bemcgarvey/SBus-Decoder/Software/SBusDecoderClient/images/servo.png

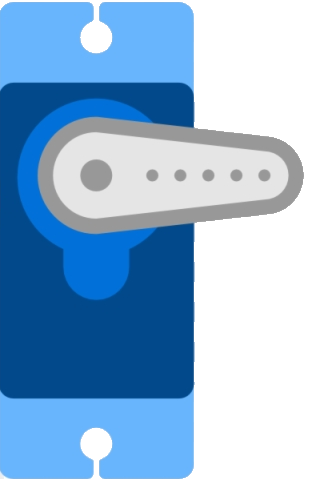
Software/SBusDecoderClient/images/servo.png
