bemcgarvey/SBus-Decoder/Schematic/SBus-Decoder/SBus-Decoder.kicad_sch

## KiCad design Schematic/SBus-Decoder/SBus-Decoder.kicad_sch (2022-01-19)

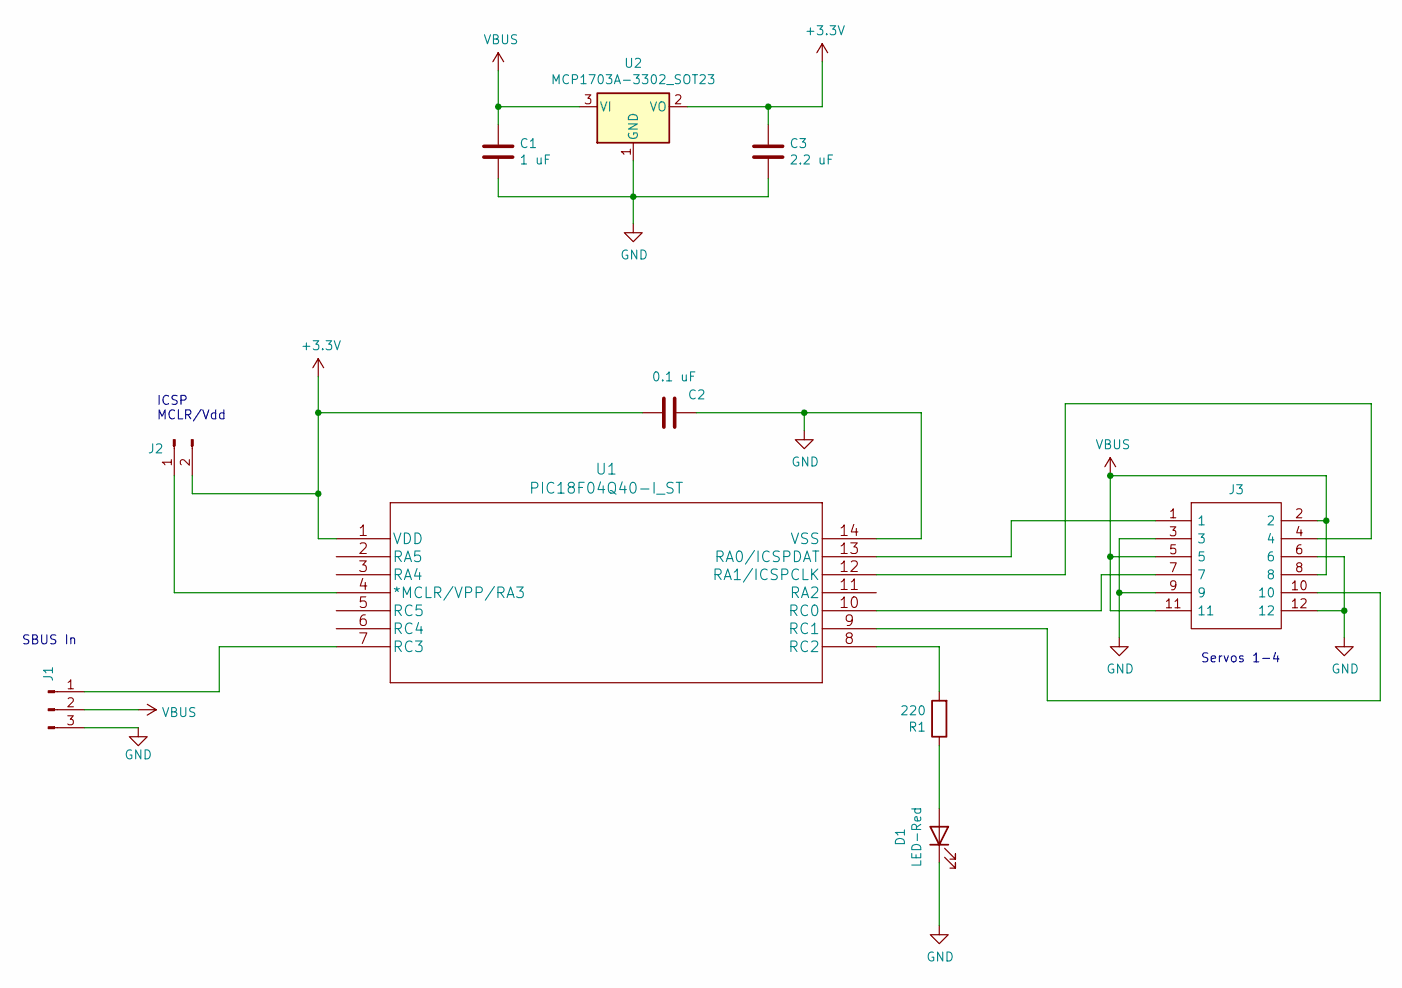
[picture p2: schematic SBus-Decoder.kicad_sch]

Parts:
C1: 1 uF; C_0603_1608Metric
C2: 0.1 uF; C_0603_1608Metric
C3: 2.2 uF; C_0603_1608Metric
D1: LED-Red; LED_0603_1608Metric
J1: Conn_01x03_Male; PinHeader_1x03_P2.54mm_Vertical
J2: Conn_01x02_Male; PinHeader_1x02_P2.54mm_Vertical
J3: TSW-104-08-G-T-RA; HDRRA12W64P254_3X4_1016X254X810P; Mouser Part Number 200-TSW10408GTRA
R1: 220; R_0603_1608Metric
U1: PIC18F04Q40-I_ST; PIC18F04Q40-I&slash_ST
U2: MCP1703A-3302_SOT23; SOT-23

Connections:
+3.3V: C2.2, C3.1, J2.2, U1.1 (VDD), U2.2 (VO)
GND: C1.2, C2.1, C3.2, D1.1 (K), J1.3, J3.3, J3.6, J3.9, J3.12, U1.14 (VSS), U2.1 (GND)
unnamed: D1.2 (A), R1.1
unnamed: J1.1, U1.7 (RC3)
unnamed: J2.1, U1.4 (*MCLR/VPP/RA3)
unnamed: J3.1, U1.13 (RA0/ICSPDAT)
unnamed: J3.4, U1.12 (RA1/ICSPCLK)
unnamed: J3.7, U1.10 (RC0)
unnamed: J3.10, U1.9 (RC1)
unnamed: R1.2, U1.8 (RC2)
VBUS: C1.1, J1.2, J3.2, J3.5, J3.8, J3.11, U2.3 (VI)

Notes on the sheet:
ICSP MCLR/Vdd
SBUS In
Servos 1-4
