bemcgarvey/SBus-Decoder/Software/SBusDecoderClient/mainwindow.cpp

#include "mainwindow.h"
#include "ui_mainwindow.h"
#include <QList>
#include <QSerialPortInfo>
#include <QMessageBox>
#include "aboutdialog.h"
#include <QTimer>
#include "stepdialog.h"
#include <cmath>
#include "version.h"

MainWindow::MainWindow(QWidget *parent)
    : QMainWindow(parent)
    , ui(new Ui::MainWindow), port(nullptr)
{
    ui->setupUi(this);
    setWindowTitle(QApplication::applicationName());
    portLabel = new QLabel("    ");
    connectedLabel = new QLabel("Not Connected");
    versionLabel = new QLabel("");
    ui->statusbar->addWidget(portLabel);
    ui->statusbar->addWidget(connectedLabel);
    ui->statusbar->addPermanentWidget(versionLabel);
    connect(ui->menuPort, &QMenu::aboutToShow, this, &MainWindow::updatePortMenu);
}

MainWindow::~MainWindow()
{
    delete ui;
}

void MainWindow::updateControls()
{
    ui->tabWidget->setCurrentIndex(settings.requestedMode - 1);
    //sBus tab
    ui->out1Channel->setCurrentIndex(settings.outputs[0].channel);
    ui->out1FrameRate->setCurrentIndex(settings.outputs[0].frameRate - 1);
    ui->out1Failsafe->setCurrentIndex(settings.outputs[0].failsafeMode - 1);
    ui->out2Channel->setCurrentIndex(settings.outputs[1].channel);
    ui->out2FrameRate->setCurrentIndex(settings.outputs[1].frameRate - 1);
    ui->out2Failsafe->setCurrentIndex(settings.outputs[1].failsafeMode - 1);
    ui->out3Channel->setCurrentIndex(settings.outputs[2].channel);
    ui->out3FrameRate->setCurrentIndex(settings.outputs[2].frameRate - 1);
    ui->out3Failsafe->setCurrentIndex(settings.outputs[2].failsafeMode - 1);
    ui->out4Channel->setCurrentIndex(settings.outputs[3].channel);
    ui->out4Failsafe->setCurrentIndex(settings.outputs[3].failsafeMode - 1);
    ui->out1Reverse->setChecked(settings.outputs[0].reverse);
    ui->out1subTrim->setValue(settings.outputs[0].subTrim);
    ui->out2Reverse->setChecked(settings.outputs[1].reverse);
    ui->out2subTrim->setValue(settings.outputs[1].subTrim);
    ui->out3Reverse->setChecked(settings.outputs[2].reverse);
    ui->out3subTrim->setValue(settings.outputs[2].subTrim);
    ui->out4Reverse->setChecked(settings.outputs[3].reverse);
    ui->out4subTrim->setValue(settings.outputs[3].subTrim);
    ui->passThrough4->setChecked(settings.options & SBUS_PASSTHROUGH4);
    ui->seqPassThrough->setChecked(settings.options & SBUS_PASSTHROUGH4);
    ui->revPassThrough->setChecked(settings.options & SBUS_PASSTHROUGH4);
    ui->passThrough3->setChecked(settings.options & SBUS_PASSTHROUGH3);
    //Sequencer tab
    if (settings.inputType == PWM) {
        ui->pwmInputRadioButton->setChecked(true);
        ui->sBusInputRadioButton->setChecked(false);
        ui->sbusOptionsFrame->setEnabled(false);
        ui->pwmInputRadioButton2->setChecked(true);
        ui->sBusInputRadioButton2->setChecked(false);
        ui->sbusOptionsFrame2->setEnabled(false);
    } else {
        ui->pwmInputRadioButton->setChecked(false);
        ui->sBusInputRadioButton->setChecked(true);
        ui->sbusOptionsFrame->setEnabled(true);
        ui->pwmInputRadioButton2->setChecked(false);
        ui->sBusInputRadioButton2->setChecked(true);
        ui->sbusOptionsFrame2->setEnabled(true);
    }
    ui->sBusInputChannel->setCurrentIndex(settings.sBusChannel);
    lowSteps.clear();
    for (int i = 0; i < settings.numLowSteps; ++i) {
        lowSteps.append(settings.lowSteps[i]);
    }
    highSteps.clear();
    for (int i = 0; i < settings.numHighSteps; ++i) {
        highSteps.append(settings.highSteps[i]);
    }
    updateLowSequenceList();
    updateHighSequenceList();
    //Reverser tab
    ui->revOut1->setChecked(settings.options & REV_OUT1);
    ui->revOut2->setChecked(settings.options & REV_OUT2);
    ui->revOut3->setChecked(settings.options & REV_OUT3);
    ui->revOut4->setChecked(settings.options & REV_OUT4);
    ui->revSubTrim->setValue(settings.revSubTrim);
    //Randomizer pad
    ui->randMaxServo->setValue(settings.random_max_servo);
    ui->randMinServo->setValue(settings.random_min_servo);
    ui->randMaxMove->setValue(settings.random_max_move);
    ui->randMinMove->setValue(settings.random_min_move);
    ui->randMaxTime->setValue(settings.random_max_time / 10.0);
    ui->randMinTime->setValue(settings.random_min_time / 10.0);
}


void MainWindow::updateSettings()
{
    //sBus tab
    settings.requestedMode = ui->tabWidget->currentIndex() + 1;
    settings.outputs[0].channel = ui->out1Channel->currentIndex();
    settings.outputs[0].frameRate = ui->out1FrameRate->currentIndex() + 1;
    settings.outputs[0].failsafeMode = ui->out1Failsafe->currentIndex() + 1;
    settings.outputs[1].channel = ui->out2Channel->currentIndex();
    settings.outputs[1].frameRate = ui->out2FrameRate->currentIndex() + 1;
    settings.outputs[1].failsafeMode = ui->out2Failsafe->currentIndex() + 1;
    settings.outputs[2].channel = ui->out3Channel->currentIndex();
    settings.outputs[2].frameRate = ui->out3FrameRate->currentIndex() + 1;
    settings.outputs[2].failsafeMode = ui->out3Failsafe->currentIndex() + 1;
    settings.outputs[3].channel = ui->out4Channel->currentIndex();
    settings.outputs[3].frameRate = ui->out4FrameRate->currentIndex() + 1;
    settings.outputs[3].failsafeMode = ui->out4Failsafe->currentIndex() + 1;
    settings.outputs[0].reverse = ui->out1Reverse->isChecked();
    settings.outputs[0].subTrim = ui->out1subTrim->value();
    settings.outputs[1].reverse = ui->out2Reverse->isChecked();
    settings.outputs[1].subTrim = ui->out2subTrim->value();
    settings.outputs[2].reverse = ui->out3Reverse->isChecked();
    settings.outputs[2].subTrim = ui->out3subTrim->value();
    settings.outputs[3].reverse = ui->out4Reverse->isChecked();
    settings.outputs[3].subTrim = ui->out4subTrim->value();
    if (ui->passThrough4->isChecked() || ui->seqPassThrough->isChecked()) {
        settings.options |= SBUS_PASSTHROUGH4;
    } else {
        settings.options &= ~SBUS_PASSTHROUGH4;
    }
    if (ui->passThrough3->isChecked()) {
        settings.options |= SBUS_PASSTHROUGH3;
    } else {
        settings.options &= ~SBUS_PASSTHROUGH3;
    }
    //Sequencer tab (some shared with reverser tab)
    if (ui->pwmInputRadioButton->isChecked()) {
        settings.inputType = PWM;
    } else {
        settings.inputType = SBUS;
    }
    settings.sBusChannel = ui->sBusInputChannel->currentIndex();
    settings.numLowSteps = lowSteps.size();
    for (int i = 0; i < lowSteps.size(); ++i) {
        settings.lowSteps[i] = lowSteps[i];
    }
    settings.numHighSteps = highSteps.size();
    for (int i = 0; i < highSteps.size(); ++i) {
        settings.highSteps[i] = highSteps[i];
    }
    //Reverser Tab
    settings.revSubTrim = ui->revSubTrim->value();
    if (ui->revOut1->isChecked()) {
        settings.options |= REV_OUT1;
    } else {
        settings.options &= ~REV_OUT1;
    }
    if (ui->revOut2->isChecked()) {
        settings.options |= REV_OUT2;
    } else {
        settings.options &= ~REV_OUT2;
    }
    if (ui->revOut3->isChecked()) {
        settings.options |= REV_OUT3;
    } else {
        settings.options &= ~REV_OUT3;
    }
    if (ui->revOut4->isChecked()) {
        settings.options |= REV_OUT4;
    } else {
        settings.options &= ~REV_OUT4;
    }
    //Randomizer Tab
    settings.random_max_servo = ui->randMaxServo->value();
    settings.random_min_servo = ui->randMinServo->value();
    if (settings.random_min_servo > settings.random_max_servo) {
        settings.random_min_servo = settings.random_max_servo;
    }
    settings.random_max_move = ui->randMaxMove->value();
    settings.random_min_move = ui->randMinMove->value();
    if (settings.random_min_move > settings.random_max_move) {
        settings.random_min_move = settings.random_max_move;
    }
    settings.random_max_time = static_cast<uint16_t>(std::round(ui->randMaxTime->value() * 10));
    settings.random_min_time = static_cast<uint16_t>(std::round(ui->randMinTime->value() * 10));
    if (settings.random_min_time > settings.random_max_time) {
        settings.random_min_time = settings.random_max_time;
    }
}

QString MainWindow::itemString(const SequenceStep &step) const
{
    QString str;
    if (step.type == SERVO) {
        str = QString("Output %1 to %2% in %3s")
                .arg(step.output)
                .arg(round((step.position - 1024) * (150.0 / 1024.0)))
                .arg(step.time / 10.0);
    } else {
        str = QString("Delay %1s").arg(step.time / 10.0);
    }
    return str;
}

void MainWindow::updatePortMenu()
{
    QList<QSerialPortInfo> portList = QSerialPortInfo::availablePorts();
    ui->menuPort->clear();
    if (portList.size() == 0) {
        ui->menuPort->addAction("No ports found");
        portLabel->setText("    ");
        connectedLabel->setText("Not Connected");
        return;
    }
    for (auto&& i : portList) {
        QAction *action = ui->menuPort->addAction(i.portName(), this, &MainWindow::comPortSelected);
        action->setCheckable(true);
        if (i.portName() == portLabel->text()) {
            action->setChecked(true);
        }
    }
}

void MainWindow::comPortSelected()
{
    QAction *action = dynamic_cast<QAction *>(sender());
    port.reset(new QSerialPort(action->text(), this));
    if (port->open(QIODevice::ReadWrite)) {
        port->setBaudRate(QSerialPort::Baud115200);
        port->setDataBits(QSerialPort::Data8);
        port->setParity(QSerialPort::NoParity);
        port->setStopBits(QSerialPort::OneStop);
        portLabel->setText(action->text());
        connectedLabel->setText("Connected");
        ui->readPushButton->setEnabled(true);
        action->setChecked(true);
        port->clear(QSerialPort::AllDirections);  //clear out extra bytes from device power on
        connect(port.get(), &QSerialPort::readyRead, this, &MainWindow::onReadyRead);
    } else {
        port.release();
        portLabel->setText("    ");
        connectedLabel->setText("Not Connected");
        ui->readPushButton->setEnabled(false);
        ui->writePushButton->setEnabled(false);
    }
}

void MainWindow::onReadyRead()
{
    int received;
    while (port->bytesAvailable() > 0) {
        switch (rxState) {
        case RX_IDLE:
            port->clear(QSerialPort::Input);
            break;
        case RX_VERSION:
            received = port->read(bufferPos, bytesNeeded);
            bytesNeeded -= received;
            bufferPos += received;
            if (bytesNeeded == 0) {
                versionLabel->setText(QString("Firmware Version %1.%2")
                        .arg(static_cast<int>(rxBuffer[0]))
                        .arg(static_cast<int>(rxBuffer[1])));
                if (rxBuffer[0] != MAJOR_VERSION || rxBuffer[1] != MINOR_VERSION) {
                    rxState = RX_IDLE;
                    QMessageBox::critical(this, QApplication::applicationName(),
                                          "Firmware out of date.  Please update firmware.");
                    ui->readPushButton->setEnabled(true);
                    //ui->writePushButton->setEnabled(true);
                } else {
                    char cmd = 's';
                    port->write(&cmd, 1);
                    rxState = RX_SETTINGS;
                    bytesNeeded = sizeof(Settings) + 1; //Extra byte for checksum
                    bufferPos = rxBuffer;
                }
            }
            break;
        case RX_SETTINGS:
            received = port->read(bufferPos, bytesNeeded);
            bytesNeeded -= received;
            bufferPos += received;
            if (bytesNeeded == 0) {
                uint8_t chk = calcChecksum(reinterpret_cast<uint8_t *>(rxBuffer));
                if (chk == static_cast<uint8_t>(rxBuffer[sizeof (Settings)])) {
                    memcpy(&settings, rxBuffer, sizeof(Settings));
                    rxState = RX_IDLE;
                    updateControls();
                } else {
                    QMessageBox::critical(this, QApplication::applicationName(), "Error reading device");
                }
                ui->readPushButton->setEnabled(true);
                ui->writePushButton->setEnabled(true);
            }
            break;
        case RX_ACK:
            received = port->read(bufferPos, bytesNeeded);
            bytesNeeded -= received;
            bufferPos += received;
            if (bytesNeeded == 0) {
                rxState = RX_IDLE;
                if (rxBuffer[0] == ACK) {
                    QMessageBox::information(this, QApplication::applicationName(), "Settings saved");
                } else {
                    QMessageBox::critical(this, QApplication::applicationName(), "An Error occurred while saving settings.");
                }
                ui->readPushButton->setEnabled(true);
                ui->writePushButton->setEnabled(true);
            }
            break;
        }
    }
}


void MainWindow::on_actionExit_triggered()
{
    close();
}


void MainWindow::on_readPushButton_clicked()
{
    char tx = 'v';
    port->write(&tx, 1);
    bytesNeeded = 2;
    bufferPos = rxBuffer;
    rxState = RX_VERSION;
    QTimer::singleShot(500, this, &MainWindow::rxTimeout);
    ui->readPushButton->setEnabled(false);
    ui->writePushButton->setEnabled(false);
}


void MainWindow::on_out3FrameRate_currentIndexChanged(int index)
{
    ui->out4FrameRate->setCurrentIndex(index);
}


void MainWindow::on_writePushButton_clicked()
{
    updateSettings();
    if (settings.requestedMode == SERVO_SEQUENCER) {
        bool valid = true;
        if (settings.options & SBUS_PASSTHROUGH4) {
            for (int i = 0; i < settings.numLowSteps; ++i) {
                if (settings.lowSteps[i].output == 4) {
                    valid = false;
                }
            }
            for (int i = 0; i < settings.numHighSteps; ++i) {
                if (settings.highSteps[i].output == 4) {
                    valid = false;
                }
            }
            if (!valid) {
                QMessageBox::warning(this, QApplication::applicationName(),
                    "sBus passthrough is enabled on output 4"
                    " and at least one event uses output 4.  "
                    "Please correct the conflict before proceeding.");
                return;
            }
        }
    }
    char cmd = 'u';
    port->write(&cmd, 1);
    port->write(reinterpret_cast<char *>(&settings.requestedMode), sizeof(Settings));
    uint8_t chksum = calcChecksum(reinterpret_cast<uint8_t *>(&settings));
    port->write(reinterpret_cast<char *>(&chksum), 1);
    rxState = RX_ACK;
    bytesNeeded = 1;
    bufferPos = rxBuffer;
    rxBuffer[0] = 0xff; //make sure there is not a left over ACK in the buffer
    QTimer::singleShot(3000, this, &MainWindow::rxTimeout);
    ui->readPushButton->setEnabled(false);
    ui->writePushButton->setEnabled(false);
}


void MainWindow::on_actionAbout_triggered()
{
    std::unique_ptr<AboutDialog> dlg(new AboutDialog(this));
    dlg->exec();
}


void MainWindow::rxTimeout()
{
    if (rxState == RX_VERSION || rxState == RX_SETTINGS || rxState == RX_ACK) {
        rxState = RX_IDLE;
        QMessageBox::critical(this, QApplication::applicationName(), "Communication timeout.  Operation failed");
        ui->readPushButton->setEnabled(true);
        ui->writePushButton->setEnabled(true);
    }
}


void MainWindow::on_passThrough3_stateChanged(int arg1)
{
    ui->out3Channel->setCurrentIndex(0);
    ui->output3Frame->setEnabled(!arg1);
}


void MainWindow::on_passThrough4_stateChanged(int arg1)
{
    ui->out4Channel->setCurrentIndex(0);
    ui->output4Frame->setEnabled(!arg1);
    if (arg1 != ui->seqPassThrough->isChecked()) {
        ui->seqPassThrough->setChecked(arg1);
    }
    if (arg1 != ui->revPassThrough->isChecked()) {
        ui->revPassThrough->setChecked(arg1);
    }
    ui->revOut4->setEnabled(!ui->passThrough4->isChecked());
    if (ui->passThrough4->isChecked()) {
        ui->revOut4->setChecked(false);
    }

}


void MainWindow::on_pwmInputRadioButton_clicked(bool checked)
{
    ui->sbusOptionsFrame->setEnabled(!checked);
    ui->sbusOptionsFrame2->setEnabled(!checked);
    ui->pwmInputRadioButton2->setChecked(checked);
    if (checked) {
        ui->sBusInputChannel->setCurrentIndex(0);
        ui->seqPassThrough->setChecked(false);
        ui->sBusInputChannel2->setCurrentIndex(0);
        ui->revPassThrough->setChecked(false);
    }
}


void MainWindow::on_sBusInputRadioButton_clicked(bool checked)
{
    ui->sbusOptionsFrame->setEnabled(checked);
    ui->sbusOptionsFrame2->setEnabled(checked);
    ui->sBusInputRadioButton2->setChecked(checked);
}



void MainWindow::on_seqPassThrough_stateChanged(int arg1)
{
    if (arg1 != ui->passThrough4->isChecked()) {
        ui->passThrough4->setChecked(arg1);
    }
    if (arg1 != ui->revPassThrough->isChecked()) {
        ui->revPassThrough->setChecked(arg1);
    }
}


void MainWindow::on_lowPlusButton_clicked()
{
    int currentRow = ui->lowSequenceList->currentRow();
    int select = -1;
    if (lowSteps.size() < MAX_SEQUENCE_STEPS) {
        SequenceStep step;
        step.output = 1;
        step.type = SERVO;
        step.position = 1024;
        step.time = 0;
        if (currentRow == lowSteps.size() - 1 || currentRow < 0) {
            lowSteps.append(step);
            select = lowSteps.size() - 1;
        } else {
            lowSteps.insert(currentRow + 1, step);
            select = currentRow + 1;
        }
        unique_ptr<StepDialog> dlg(new StepDialog(this, lowSteps[select], !ui->passThrough4->isChecked()));
        if (dlg->exec() == QDialog::Rejected) {
            lowSteps.removeAt(select);
            select = currentRow;
        }
        updateLowSequenceList(select);
    }
}


void MainWindow::on_lowSequenceList_itemDoubleClicked(QListWidgetItem *item)
{
    Q_UNUSED(item);
    int stepNum = ui->lowSequenceList->currentRow();
    unique_ptr<StepDialog> dlg(new StepDialog(this, lowSteps[stepNum], !ui->passThrough4->isChecked()));
    if (dlg->exec() == QDialog::Accepted) {
        updateLowSequenceList(stepNum);
    }
}

void MainWindow::updateLowSequenceList(int select)
{
    ui->lowSequenceList->clear();
    for (auto &&i : lowSteps) {
        ui->lowSequenceList->addItem(itemString(i));
    }
    ui->lowSequenceList->setCurrentRow(select);
}

void MainWindow::updateHighSequenceList(int select) {
    ui->highSequenceList->clear();
    for (auto &&i : highSteps) {
        ui->highSequenceList->addItem(itemString(i));
    }
    ui->highSequenceList->setCurrentRow(select);
}

void MainWindow::on_lowXButton_clicked()
{
    int stepNum = ui->lowSequenceList->currentRow();
    if (stepNum >= 0) {
        lowSteps.removeAt(stepNum);
        updateLowSequenceList(std::max(0, stepNum - 1));
    }
}


void MainWindow::on_highPlusButton_clicked()
{
    int currentRow = ui->highSequenceList->currentRow();
    int select = -1;
    if (highSteps.size() < MAX_SEQUENCE_STEPS) {
        SequenceStep step;
        step.output = 1;
        step.type = SERVO;
        step.position = 1024;
        step.time = 0;
        if (currentRow == highSteps.size() - 1 || currentRow < 0) {
            highSteps.append(step);
            select = highSteps.size() - 1;
        } else {
            highSteps.insert(currentRow + 1, step);
            select = currentRow + 1;
        }
        unique_ptr<StepDialog> dlg(new StepDialog(this, highSteps[select], !ui->passThrough4->isChecked()));
        if (dlg->exec() == QDialog::Rejected) {
            highSteps.removeAt(select);
            select = currentRow;
        }
        updateHighSequenceList(select);
    }
}


void MainWindow::on_highXButton_clicked()
{
    int stepNum = ui->highSequenceList->currentRow();
    if (stepNum >= 0) {
        highSteps.removeAt(stepNum);
        updateHighSequenceList(std::max(0, stepNum - 1));
    }
}


void MainWindow::on_highSequenceList_itemDoubleClicked(QListWidgetItem *item)
{
    Q_UNUSED(item);
    int stepNum = ui->highSequenceList->currentRow();
    unique_ptr<StepDialog> dlg(new StepDialog(this, highSteps[stepNum], !ui->passThrough4->isChecked()));
    if (dlg->exec() == QDialog::Accepted) {
        updateHighSequenceList(stepNum);
    }
}


void MainWindow::on_lowUpButton_clicked()
{
    int pos = ui->lowSequenceList->currentRow();
    if (pos > 0) {
        lowSteps.swapItemsAt(pos, pos - 1);
        updateLowSequenceList(pos - 1);
    }
}


void MainWindow::on_lowDownButton_clicked()
{
    int pos = ui->lowSequenceList->currentRow();
    if (pos >= 0 && pos < lowSteps.size() - 1) {
        lowSteps.swapItemsAt(pos, pos + 1);
        updateLowSequenceList(pos + 1);
    }
}


void MainWindow::on_rightButton_clicked()
{
    int lowPos = ui->lowSequenceList->currentRow();
    int highPos = ui->highSequenceList->currentRow();
    if (lowPos >= 0 && highSteps.size() < MAX_SEQUENCE_STEPS) {
        if (highPos < 0) {
            highSteps.append(lowSteps[lowPos]);
            highPos = highSteps.size() - 1;
        } else {
            highPos += 1;
            highSteps.insert(highPos, lowSteps[lowPos]);
        }
        updateHighSequenceList(highPos);
    }
}


void MainWindow::on_leftButton_clicked()
{
    int lowPos = ui->lowSequenceList->currentRow();
    int highPos = ui->highSequenceList->currentRow();
    if (highPos >= 0 && lowSteps.size() < MAX_SEQUENCE_STEPS) {
        if (lowPos < 0) {
            lowSteps.append(highSteps[highPos]);
            lowPos = lowSteps.size() - 1;
        } else {
            lowPos += 1;
            lowSteps.insert(lowPos, highSteps[highPos]);
        }
        updateLowSequenceList(lowPos);
    }
}


void MainWindow::on_highUpButton_clicked()
{
    int pos = ui->highSequenceList->currentRow();
    if (pos > 0) {
        highSteps.swapItemsAt(pos, pos - 1);
        updateHighSequenceList(pos - 1);
    }
}


void MainWindow::on_highDownButton_clicked()
{
    int pos = ui->highSequenceList->currentRow();
    if (pos >= 0 && pos < highSteps.size() - 1) {
        highSteps.swapItemsAt(pos, pos + 1);
        updateHighSequenceList(pos + 1);
    }
}


void MainWindow::on_tabWidget_currentChanged(int index)
{
    ui->testButton2->setChecked(false);
    if (index != 0) {
        ui->passThrough3->setChecked(false);
    }
}

void MainWindow::setServo(int16_t value)
{
    if (port) {
        char cmd;
        if (value >= 0) {
            cmd = 't';
            port->write(&cmd, 1);
            port->write(reinterpret_cast<char *>(&value), 2);
        } else {
            cmd = 'x';
            port->write(&cmd, 1);
        }
    }
}


void MainWindow::on_sBusInputRadioButton2_clicked(bool checked)
{
    ui->sBusInputRadioButton->setChecked(checked);
    on_sBusInputRadioButton_clicked(checked);
}


void MainWindow::on_pwmInputRadioButton2_clicked(bool checked)
{
    ui->pwmInputRadioButton->setChecked(checked);
    on_pwmInputRadioButton_clicked(checked);
}


void MainWindow::on_revPassThrough_stateChanged(int arg1)
{
    if (arg1 != ui->passThrough4->isChecked()) {
        ui->passThrough4->setChecked(arg1);
    }
    if (arg1 != ui->seqPassThrough->isChecked()) {
        ui->seqPassThrough->setChecked(arg1);
    }
}


void MainWindow::on_sBusInputChannel2_currentIndexChanged(int index)
{
    if (ui->sBusInputChannel->currentIndex() != index) {
        ui->sBusInputChannel->setCurrentIndex(index);
    }
}


void MainWindow::on_sBusInputChannel_currentIndexChanged(int index)
{
    if (ui->sBusInputChannel2->currentIndex() != index) {
        ui->sBusInputChannel2->setCurrentIndex(index);
    }
}


void MainWindow::on_testButton2_toggled(bool checked)
{
    if (checked) {
        if (QMessageBox::warning(this, QApplication::applicationName(),
                                 "Before proceeding:\n"
                                 "   1) Remove the bind plug from output 4\n"
                                 "   2) Plug a servo into output 4\n"
                                 "Failure to do so can result in damage to the output pin",
                                 QMessageBox::Ok | QMessageBox::Cancel)
                == QMessageBox::Cancel) {
            ui->testButton2->setChecked(false);
            return;
        }
        setServo(ui->revSubTrim->value() + 1024);
    } else {
        setServo(-1);
    }
}


void MainWindow::on_revSubTrim_valueChanged(int arg1)
{
    if (ui->testButton2->isChecked()) {
        setServo(arg1 + 1024);
    }
}
