bemcgarvey/SBus-Decoder/Software/SBusDecoderClient/main.cpp

#include "mainwindow.h"

#include <QApplication>
#include <QScreen>

int main(int argc, char *argv[])
{
    QApplication::setOrganizationName("QES");
    QApplication::setApplicationName("sBus Decoder");
    QApplication a(argc, argv);
    MainWindow w;
    QScreen *screen = QGuiApplication::primaryScreen();
    QRect  screenGeometry = screen->geometry();
    int width = screenGeometry.width();
    w.move(width / 2 - w.width() / 2, 10);
    w.show();
    return a.exec();
}
