bemcgarvey/SBus-Decoder/Firmware/SBus-Decoder.X/version.h

/* 
 * File:   version.h
 * Author: bemcg
 *
 * Created on August 9, 2021, 8:10 PM
 */

#ifndef VERSION_H
#define	VERSION_H

#define MAJOR_VERSION   1
#define MINOR_VERSION   2

#endif	/* VERSION_H */
