bemcgarvey/SBus-Decoder/Firmware/SBus-Decoder.X/serial.h

/////////////////////////////////////////////////////
// Project: SBus-Decoder                           //
// File: serial.h                                  //
// Target: PIC18F0xQ40                             // 
// Compiler: XC8                                   //
// Author: Brad McGarvey                           //
// License: GNU General Public License v3.0        //
// Description: serial functions (non-sBus)        //
/////////////////////////////////////////////////////

#ifndef SERIAL_H
#define	SERIAL_H

#include <stdbool.h>

enum {ACK = 0x06, NACK = 0x15};

bool detectSerial(void);
void initSerial(void);
void serialTasks(void);

#endif	/* SERIAL_H */
