bemcgarvey/SBus-Decoder/(commit log)

2021-07-16 Initial Schematic
    [SBus-Decoder.kicad_pcb, SBus-Decoder.sch]
2021-07-16 Added CLC connections
    Need CLC to invert SBus serial signal
    [SBus-Decoder.sch]
2021-07-18 Switched to 32MHz Fosc
2021-07-19 Changed connectors
    [SBus-Decoder.kicad_pcb, SBus-Decoder.sch]
2021-07-19 Initial pcb
    [SBus-Decoder.kicad_pcb]
2021-07-20 Schematic and pcb
    [SBus-Decoder.kicad_pcb, SBus-Decoder.sch]
2021-07-21 Single pcb layout complete
    [SBus-Decoder.kicad_pcb]
2021-07-21 Changed input connector footprint
    Using a 2.54 pin header will allow for more flexibility for other uses (like a servo sequencer.)
    [SBus-Decoder.kicad_pcb, SBus-Decoder.sch]
2021-07-21 Better ICSP setup
    [SBus-Decoder.kicad_pcb, SBus-Decoder.sch]
2021-07-22 Paneled and generated gerbers
    [SBus-Decoder-B_Cu.gbr, SBus-Decoder-B_Mask.gbr, SBus-Decoder-B_SilkS.gbr, SBus-Decoder-Edge_Cuts.gbr, SBus-Decoder-F_Cu.gbr, SBus-Decoder-F_Mask.gbr, SBus-Decoder-F_SilkS.gbr, SBus-Decoder-NPTH.drl]
2021-08-07 Switched serial to UART2
2021-08-07 RX timer enabled
2021-08-09 Initial NCO and PWM code.
2021-08-11 Write settings to device working
2021-08-11 Fixed channel comboboxes to allow off mode
    [mainwindow.cpp]
2021-08-12 Servo reverse and sub trim working
    [main.c, main.cpp, mainwindow.cpp, sbus.c, sbus.h, sbus_settings.h, settings.c, settings.h]
2021-08-13 Enabled WDT
    Fixed bug when using passthrough. Pin needed to be an input. Also made some adjustments to config bits.
    [config_bits.c, main.c, settings.h]
2021-08-16 Sequencer pwm and sbus input working
2021-08-18 Servo test working
2021-08-23 Changed pwm input timer to use NCO
    This makes pwm counts match sBus values
2021-09-11 Improved test button behavior
2022-01-19 Converted to KiCad 6
    [SBus-Decoder.kicad_pcb, SBus-Decoder.kicad_sch, SBus-Decoder.sch]
2022-03-17 Prevent output 4 selection when sBus pass through is used
    [mainwindow.cpp, stepdialog.cpp, stepdialog.h]
2022-04-06 Changed servo output range to 800 - 2200 us
    Now in use. Any changes from here need a new version number.
2022-10-29 Fixed S.Bus flag error, improved watchdog behavior
    Firmware V1.1
    [sbus.h, settings.c, settings.h, version.h]
2023-08-06 Minor UI fixes
    Updated scaling for Qt 6
    [main.cpp]
